CraigB-spinner/Arcade-Trackball/5050RGB_Pics/5050RGB circuit & pre-board.jpg

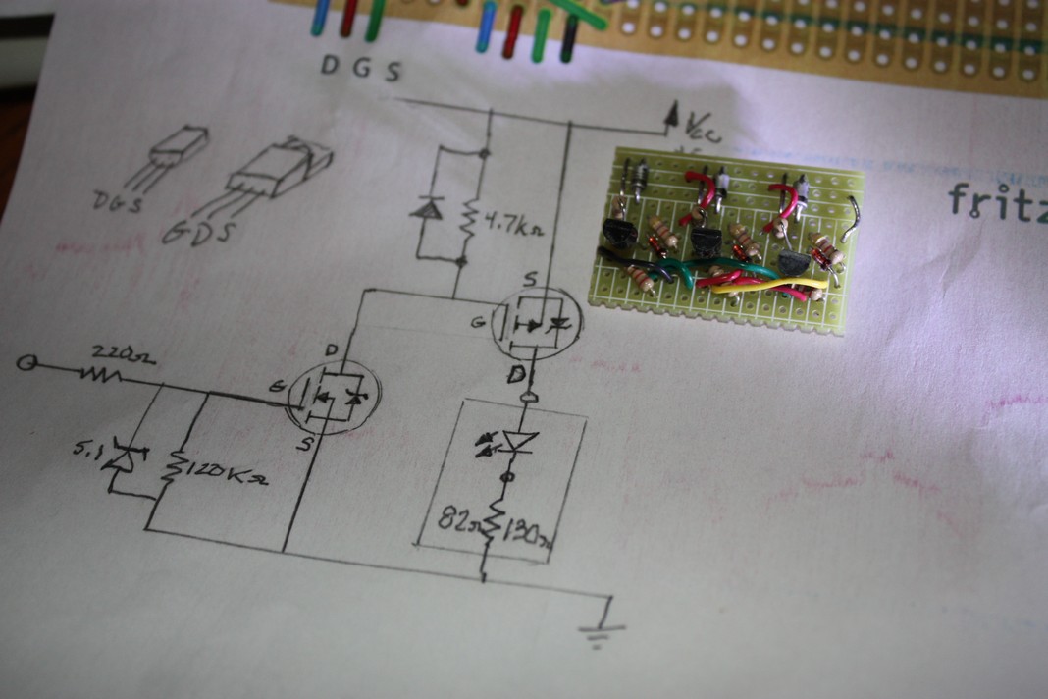
5050RGB_Pics/5050RGB circuit & pre-board.jpg
