CraigB-spinner/Arcade-Trackball/5050RGB_Pics/5050RGB strip wired.jpg

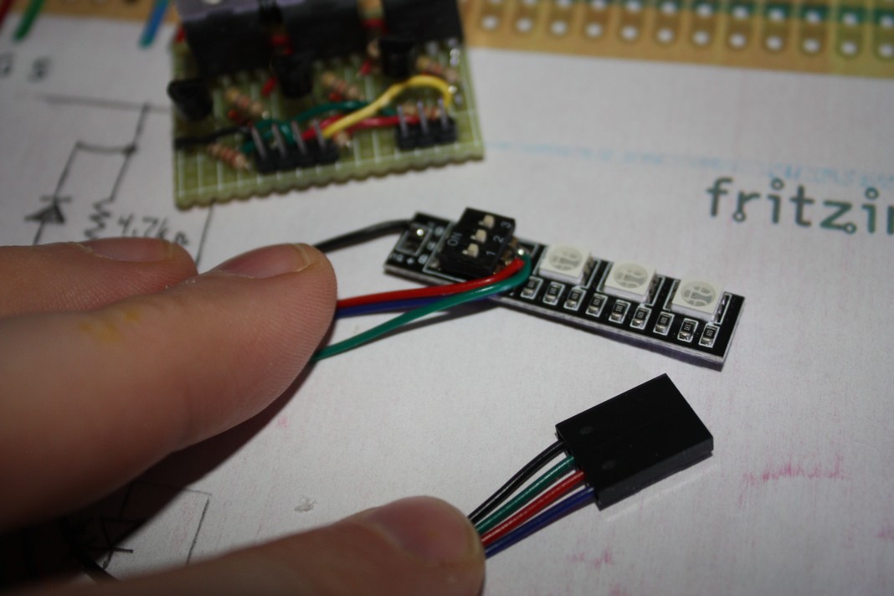
5050RGB_Pics/5050RGB strip wired.jpg
