CraigB-spinner/Arcade-Trackball/5050RGB_Pics/Finished 5050RGB driver.jpg

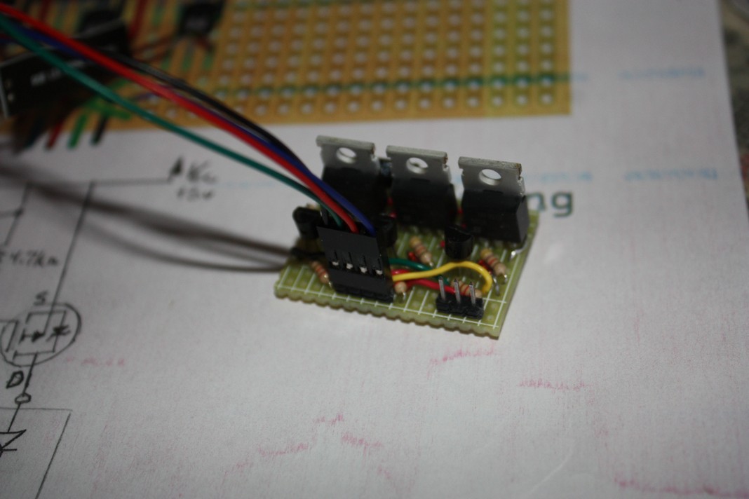
5050RGB_Pics/Finished 5050RGB driver.jpg
