CraigB-spinner/Arcade-Trackball/5050RGB_Pics/MOSFET-3-LED-Strip(red)-cc-3.jpg

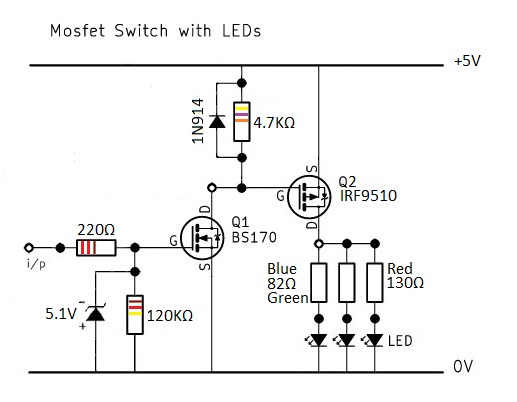
5050RGB_Pics/MOSFET-3-LED-Strip(red)-cc-3.jpg
