CraigB-spinner/Arcade-Trackball/5050RGB_Pics/RGB5050 circuit Sketch_bb.jpg

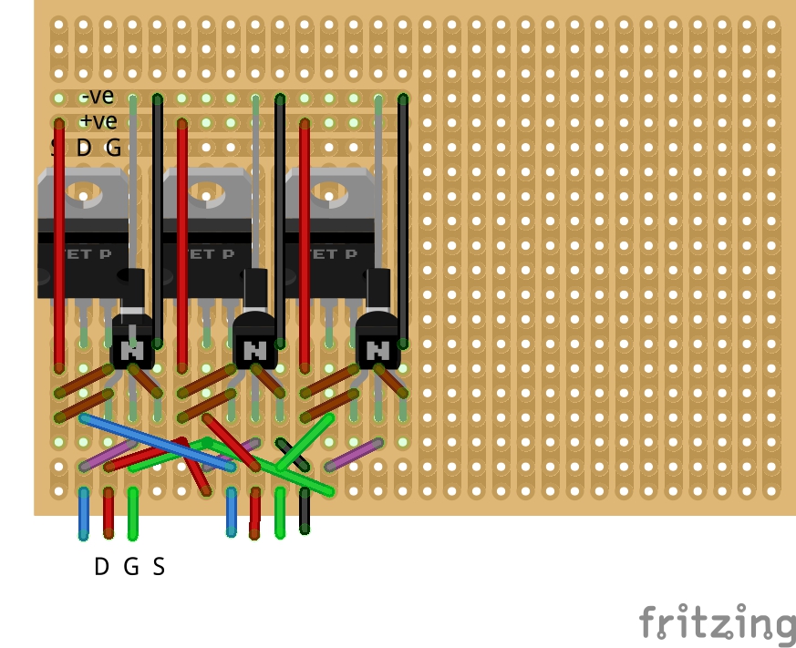
5050RGB_Pics/RGB5050 circuit Sketch_bb.jpg
