CraigB-spinner/Arcade-Trackball/Finished pictures/ATmega32U4 wired inside.jpg

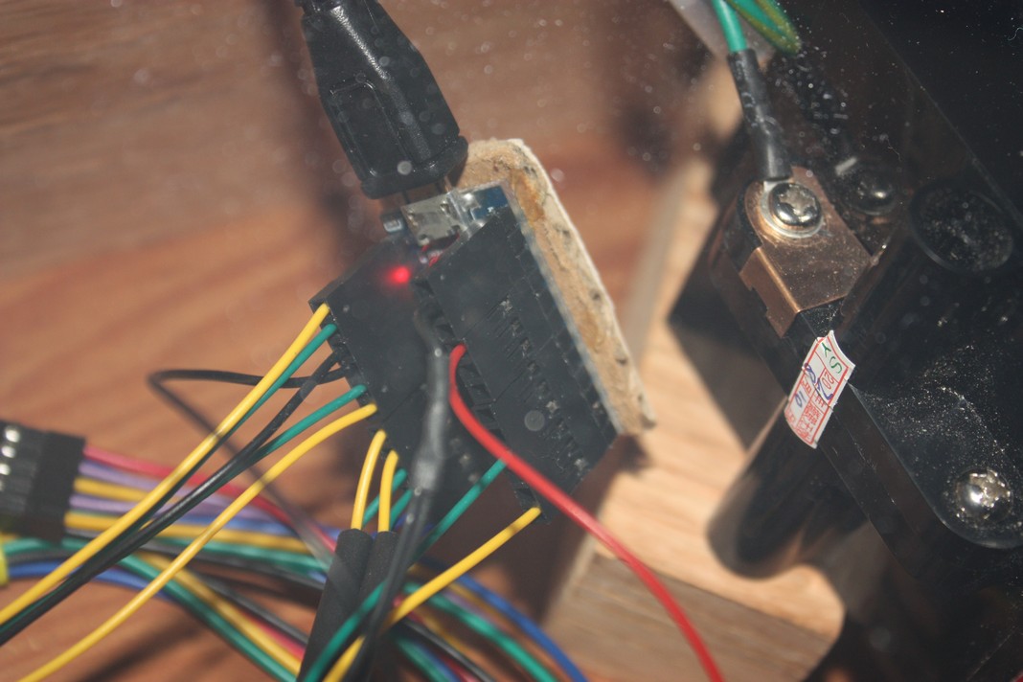
Finished pictures/ATmega32U4 wired inside.jpg
