CraigB-spinner/Arcade-Trackball/Finished pictures/Bottom-side.jpg

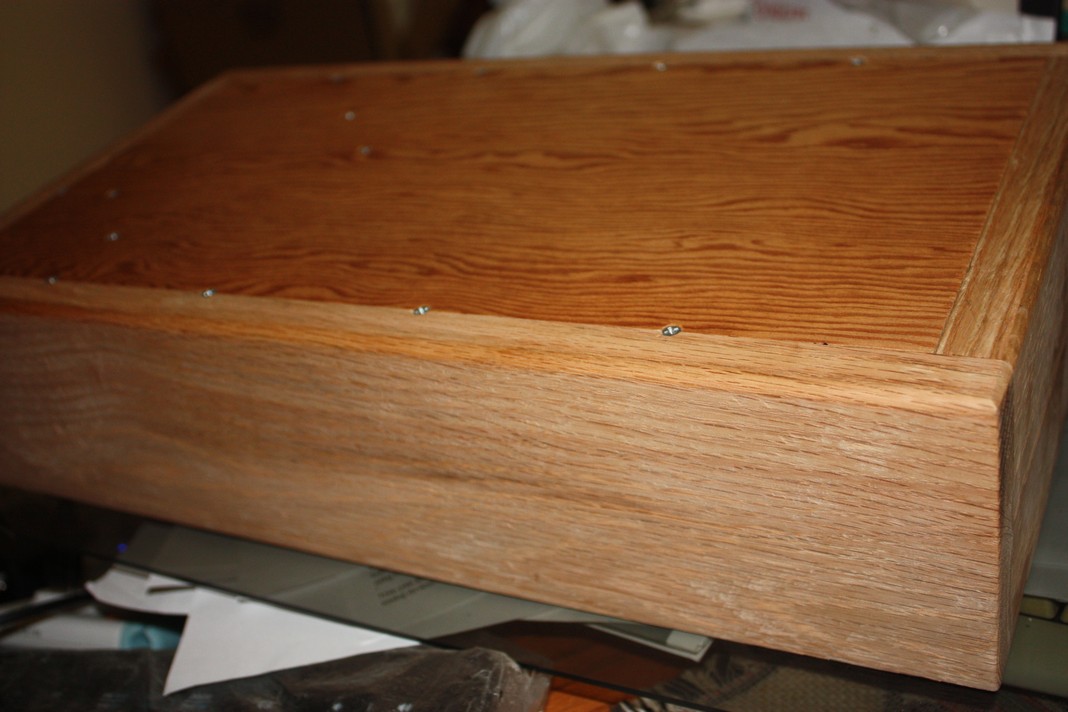
Finished pictures/Bottom-side.jpg
