CraigB-spinner/Arcade-Trackball/Finished pictures/Buttons.jpg

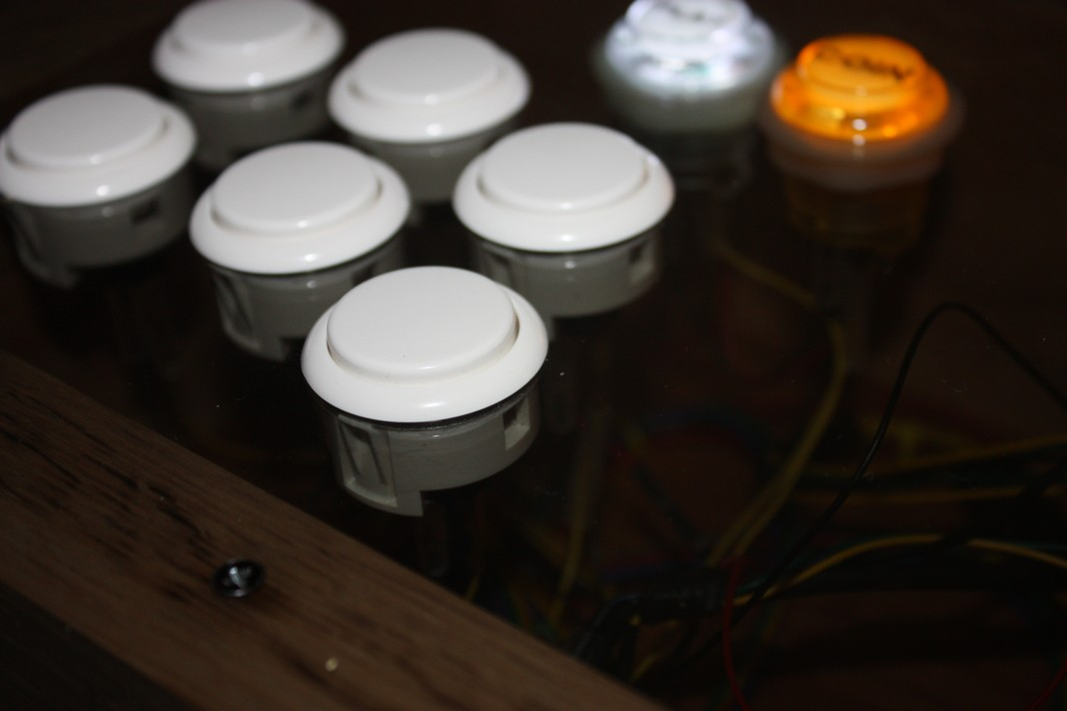
Finished pictures/Buttons.jpg
