CraigB-spinner/Arcade-Trackball/Finished pictures/See-thru-Top.jpg

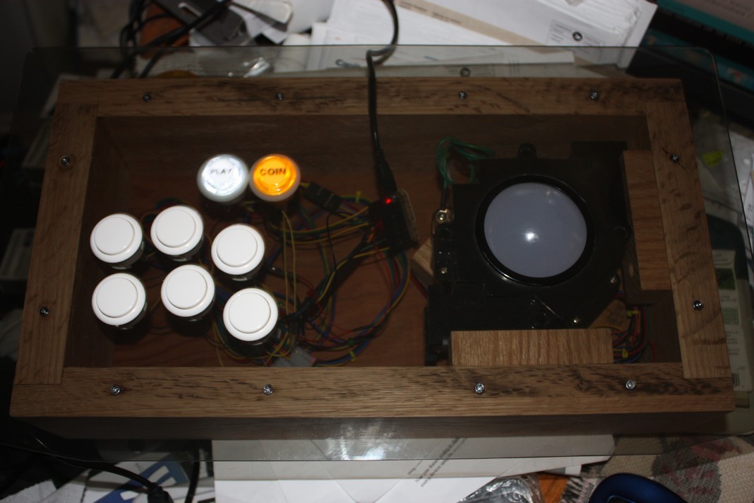
Finished pictures/See-thru-Top.jpg
