CraigB-spinner/Arcade-Trackball/Finished pictures/Trackball.jpg

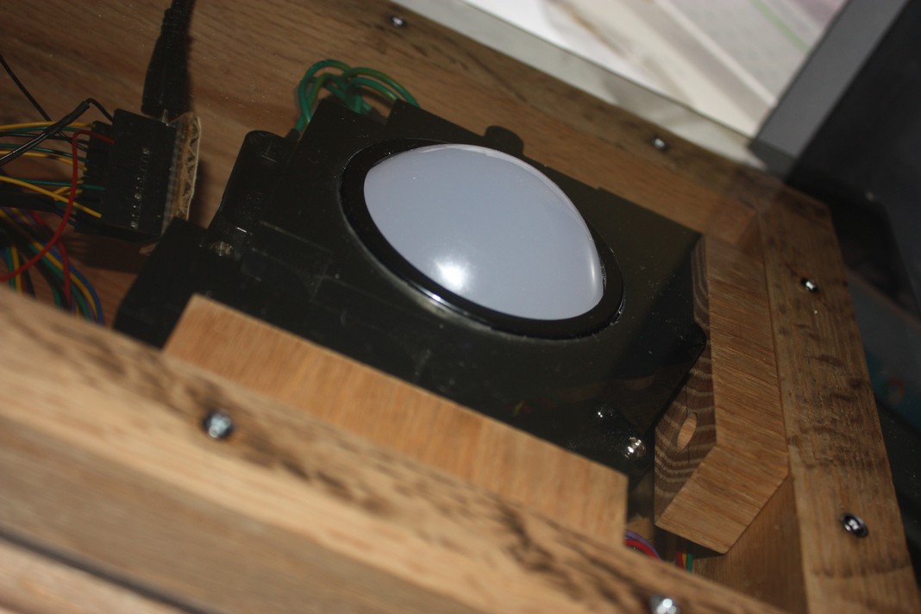
Finished pictures/Trackball.jpg
