CraigB-spinner/Arcade-Trackball/ICSP_Pics/ATMega32U4 - Fuse bits - Extended.jpg

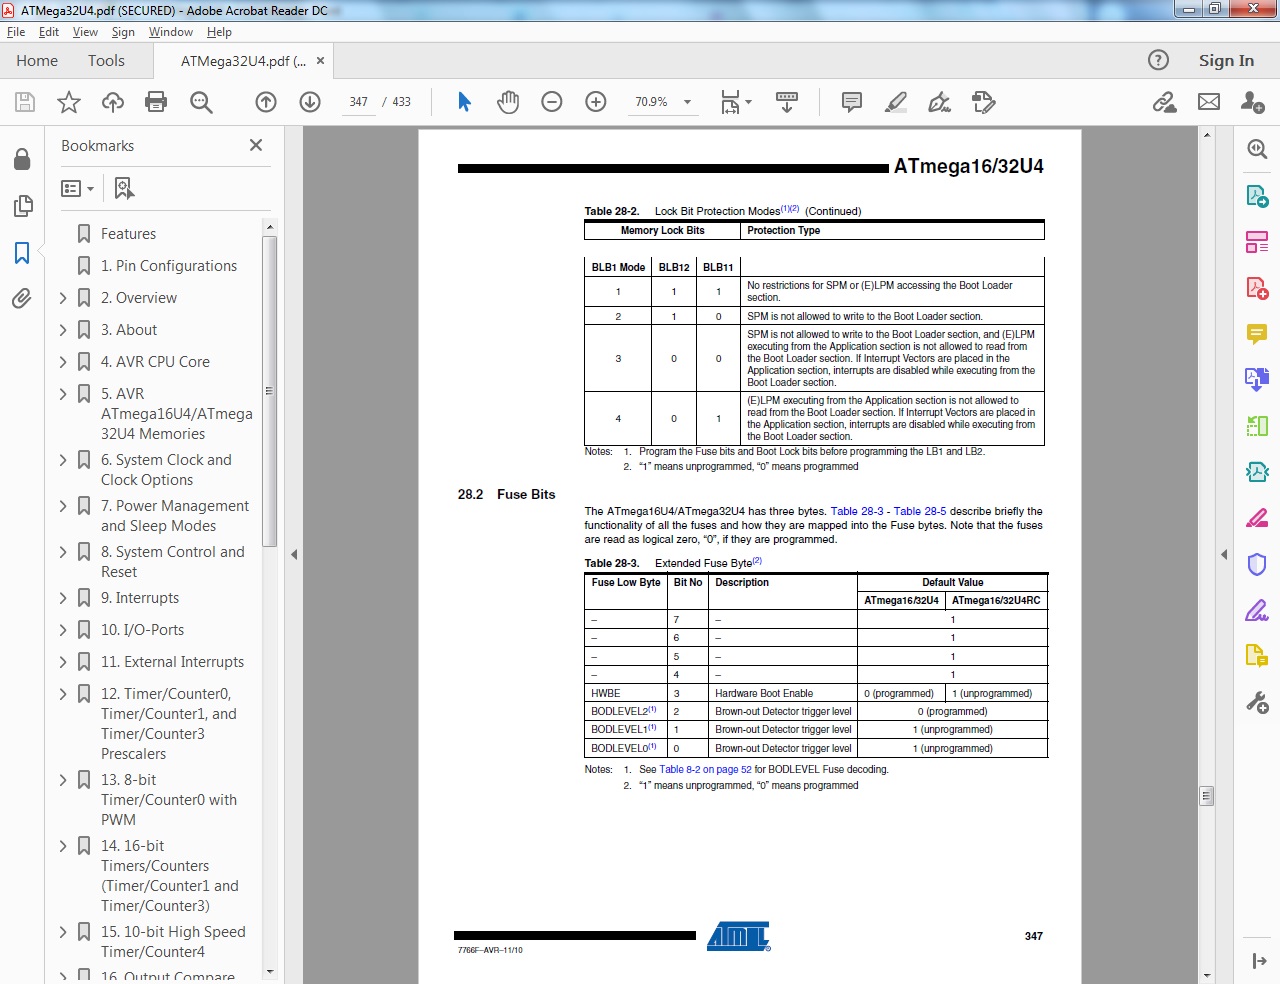
ICSP_Pics/ATMega32U4 - Fuse bits - Extended.jpg
