CraigB-spinner/Arcade-Trackball/ICSP_Pics/ATMega32U4 - Fuse bits - High & Low.jpg

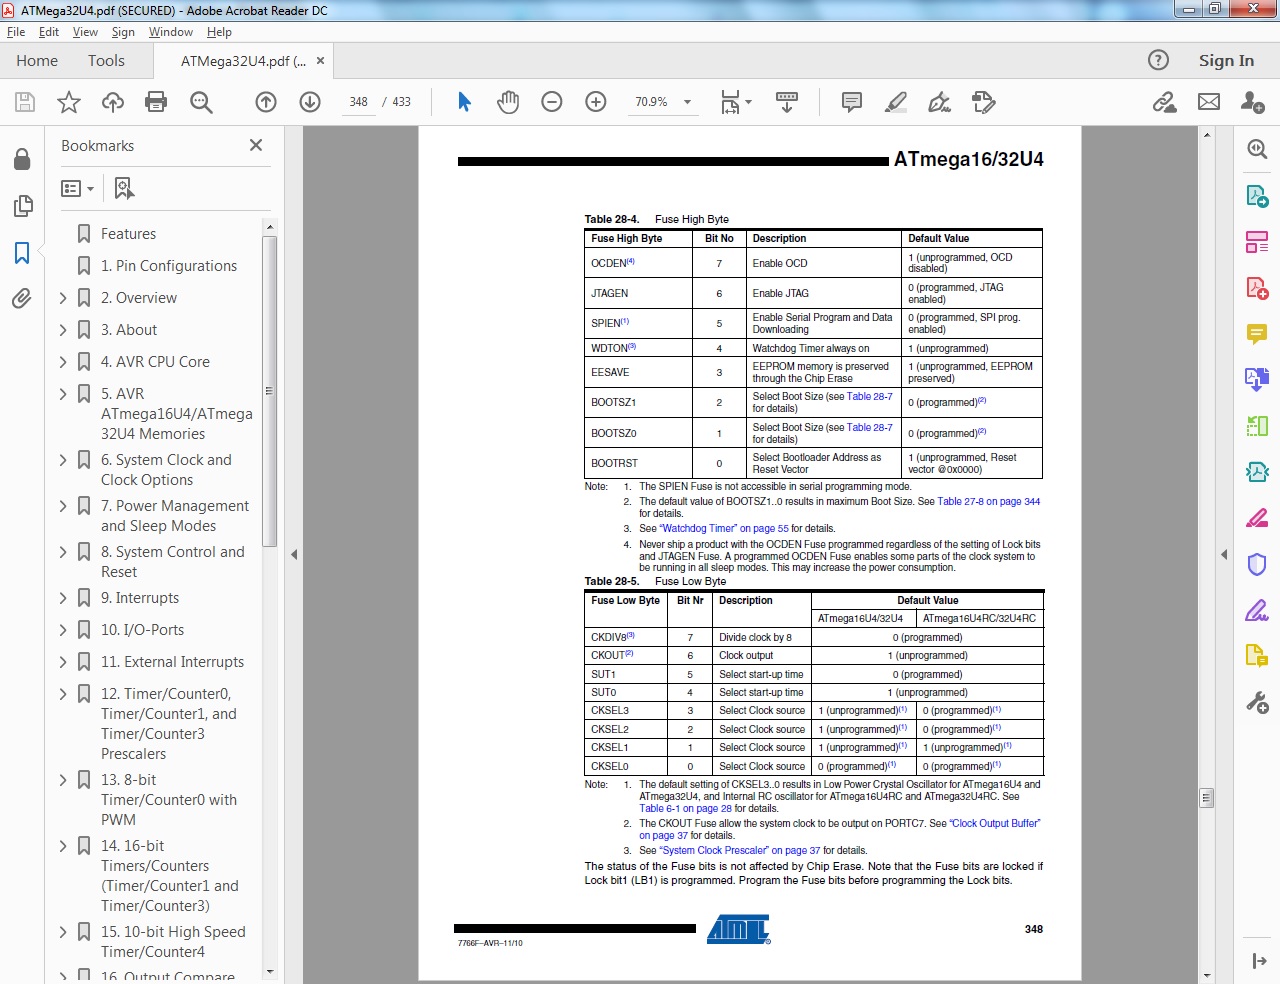
ICSP_Pics/ATMega32U4 - Fuse bits - High & Low.jpg
