CraigB-spinner/Arcade-Trackball/ICSP_Pics/ATMega32U4 - Lock bits.jpg

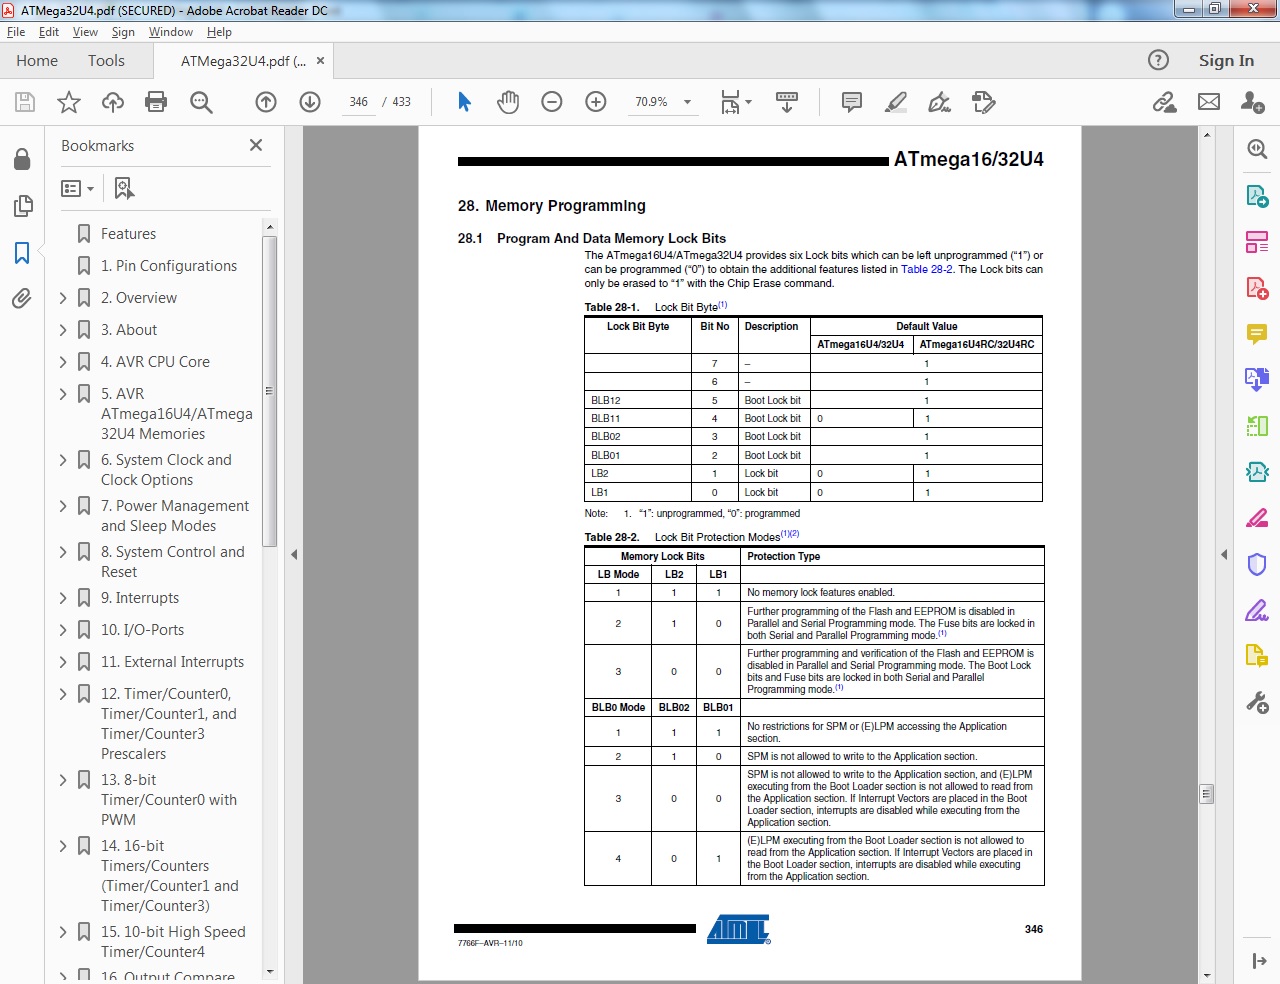
ICSP_Pics/ATMega32U4 - Lock bits.jpg
