CraigB-spinner/Arcade-Trackball/ICSP_Pics/AVRDUDESS bits.xml file update for Fuse & Lock Bits.jpg

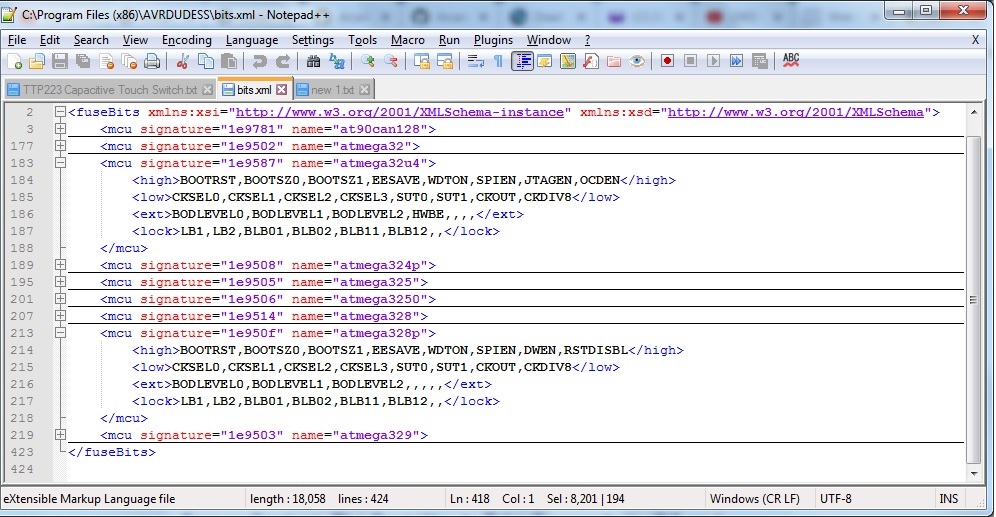
ICSP_Pics/AVRDUDESS bits.xml file update for Fuse & Lock Bits.jpg
