CraigB-spinner/Arcade-Trackball/ICSP_Pics/AVRDUDESS Fuse & Lock Bits.jpg

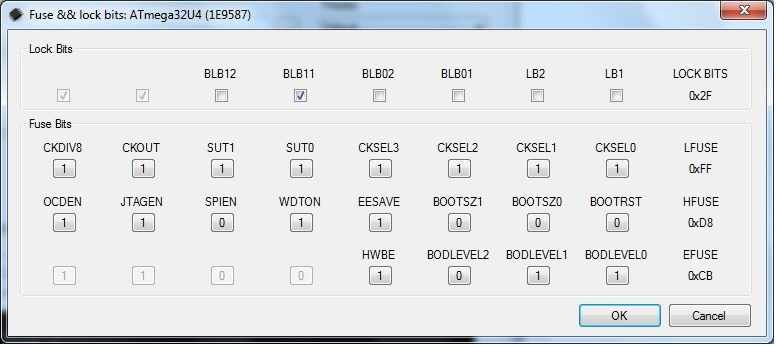
ICSP_Pics/AVRDUDESS Fuse & Lock Bits.jpg
