CraigB-spinner/Arcade-Trackball/ICSP_Pics/AVRDUDESS.jpg

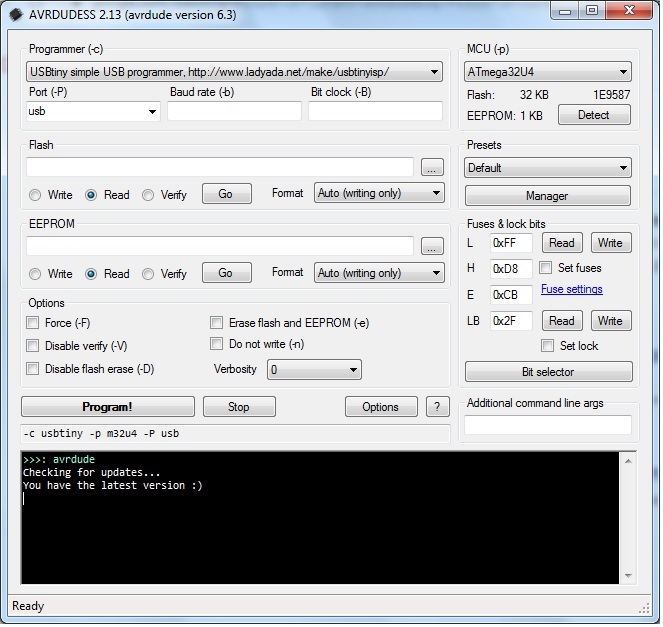
ICSP_Pics/AVRDUDESS.jpg
