CraigB-spinner/Arcade-Trackball/ICSP_Pics/USBtiny - Device Manager.jpg

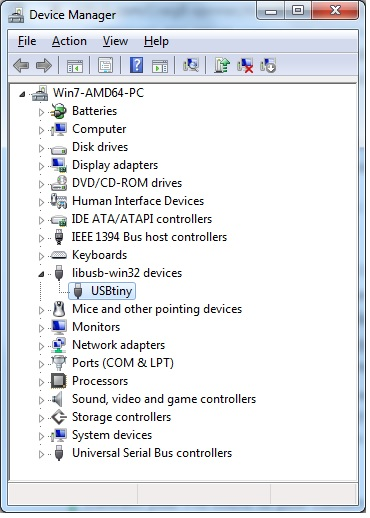
ICSP_Pics/USBtiny - Device Manager.jpg
