CraigB-spinner/Arcade-Trackball/Pics/MOSFET-3-LED-Strip(red)-ca.jpg

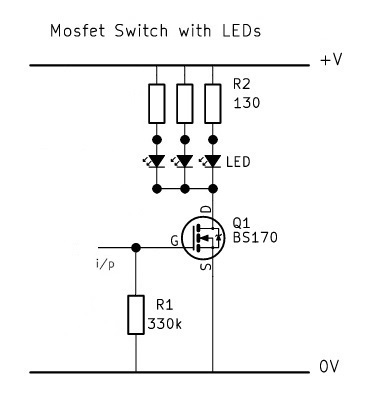
Pics/MOSFET-3-LED-Strip(red)-ca.jpg
