CraigB-spinner/Arcade-Trackball/Pics/MOSFET-3-LED-Strip(red)-cc.jpg

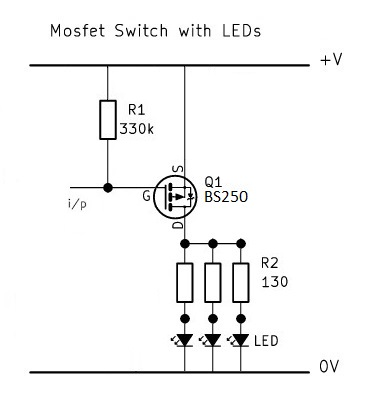
Pics/MOSFET-3-LED-Strip(red)-cc.jpg
