CraigB-spinner/Arcade-Trackball/Pics/RA-TRACK-BALL-No-Harness.jpg

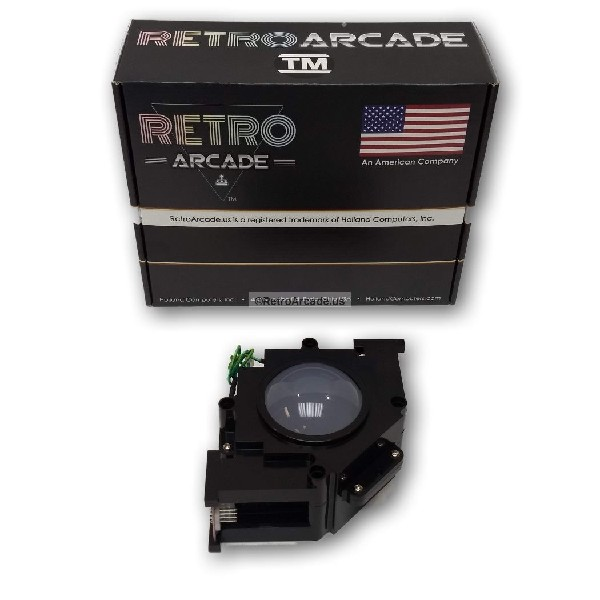
Pics/RA-TRACK-BALL-No-Harness.jpg
