CraigB-spinner/Arcade-Trackball/Pics/RA-TRACKBALL-1-Jamma-60-in-1.jpg

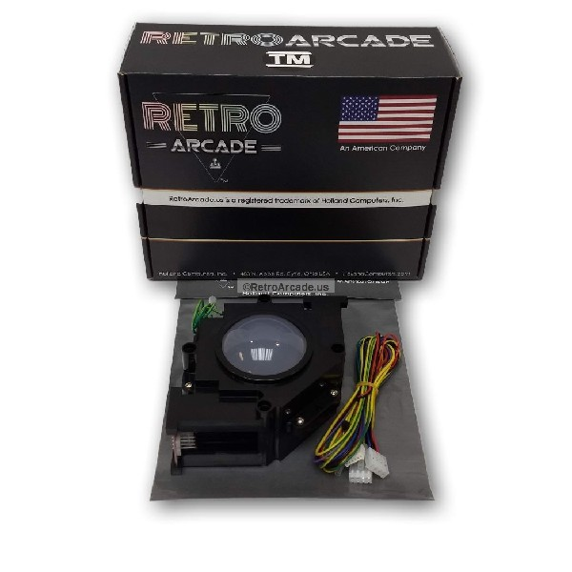
Pics/RA-TRACKBALL-1-Jamma-60-in-1.jpg
