CraigB-spinner/Arcade-Trackball/Pics/RA-Trackball-2 dimensions.jpg

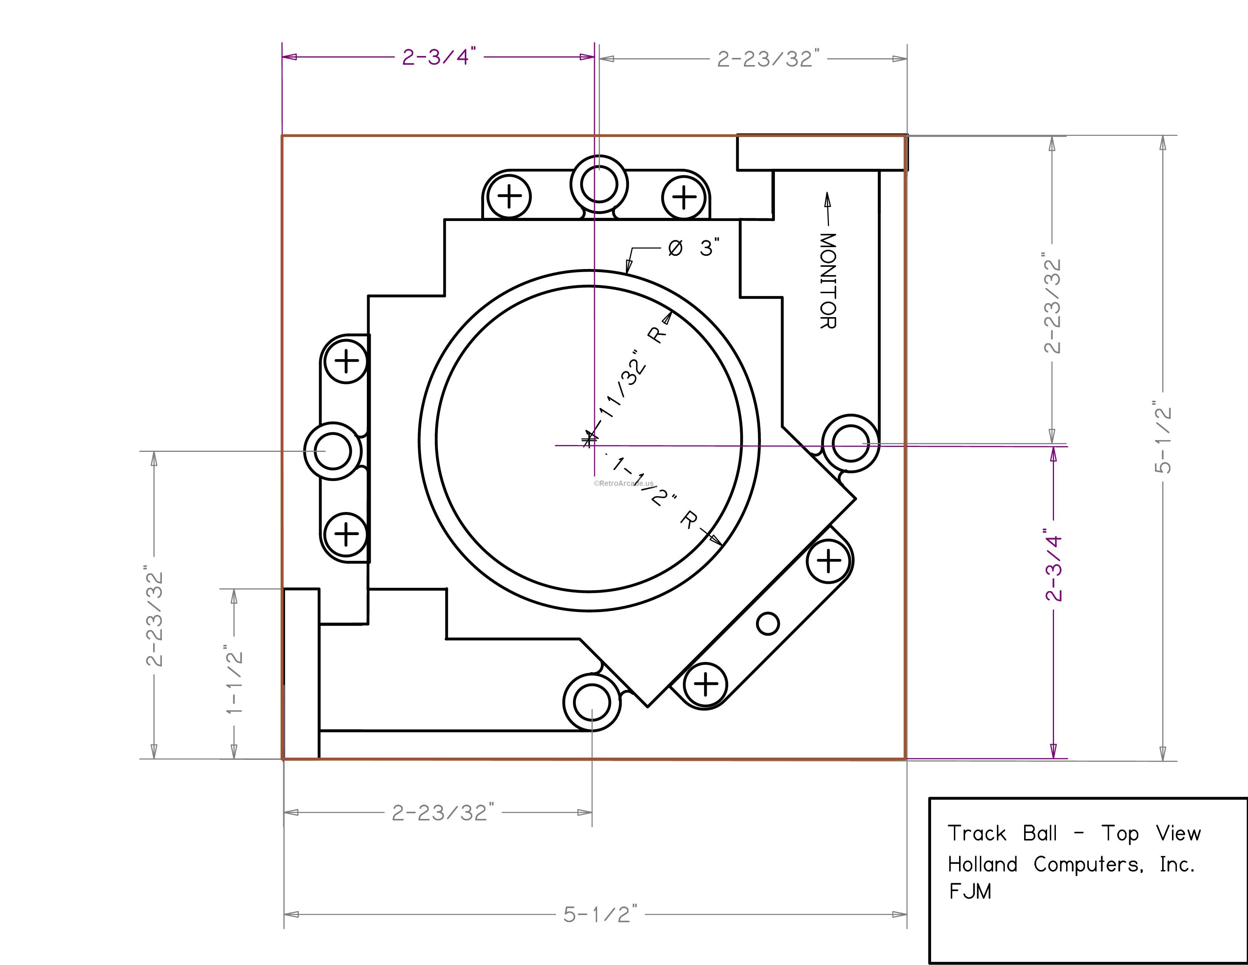
Pics/RA-Trackball-2 dimensions.jpg
