CraigB-spinner/Arcade-Trackball/Pics/RA-TRACKBALL-2-GameElf-412-in-1.jpg

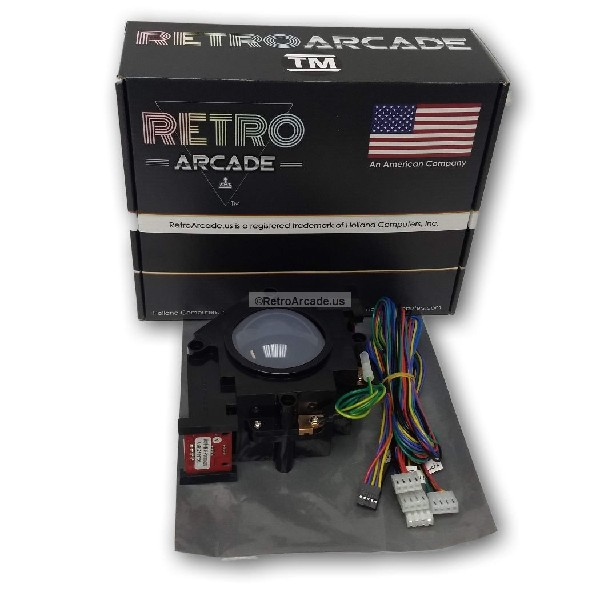
Pics/RA-TRACKBALL-2-GameElf-412-in-1.jpg
