CraigB-spinner/Arcade-Trackball/Pics/Red_Board_Pinout.jpg

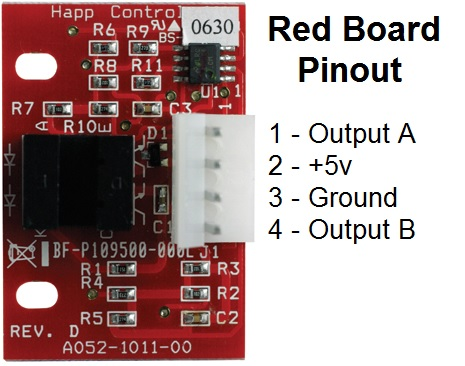
Pics/Red_Board_Pinout.jpg
