CraigB-spinner/Arcade-Trackball/Pics/Retro Arcade 3in Trackball and Harness.jpg

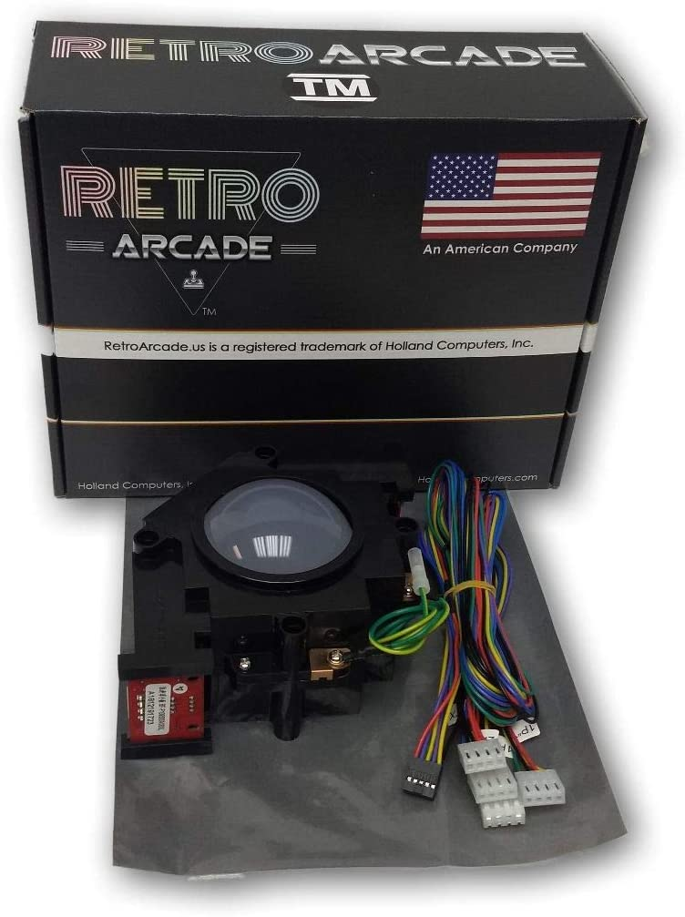
Pics/Retro Arcade 3in Trackball and Harness.jpg
