CraigB-spinner/Arcade-Trackball/Pics/RGB5050_board.jpg

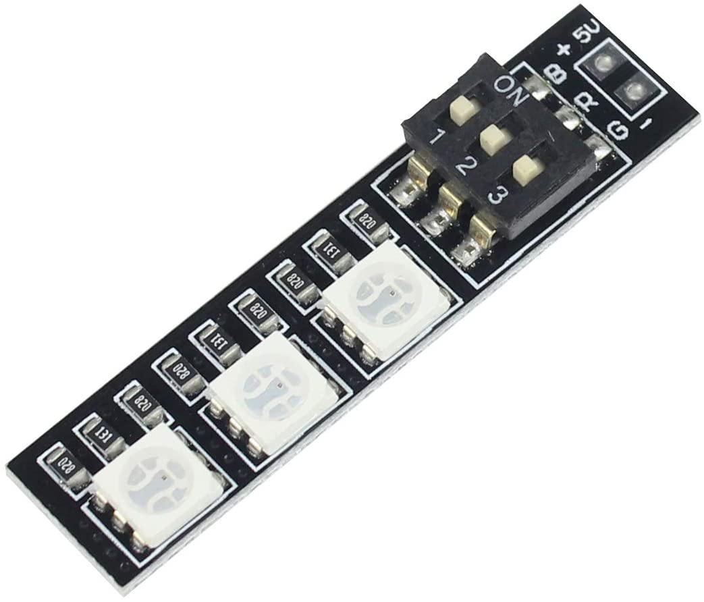
Pics/RGB5050_board.jpg
