CraigB-spinner/Arcade-Trackball/Pics/Special Touch Buttons.jpg

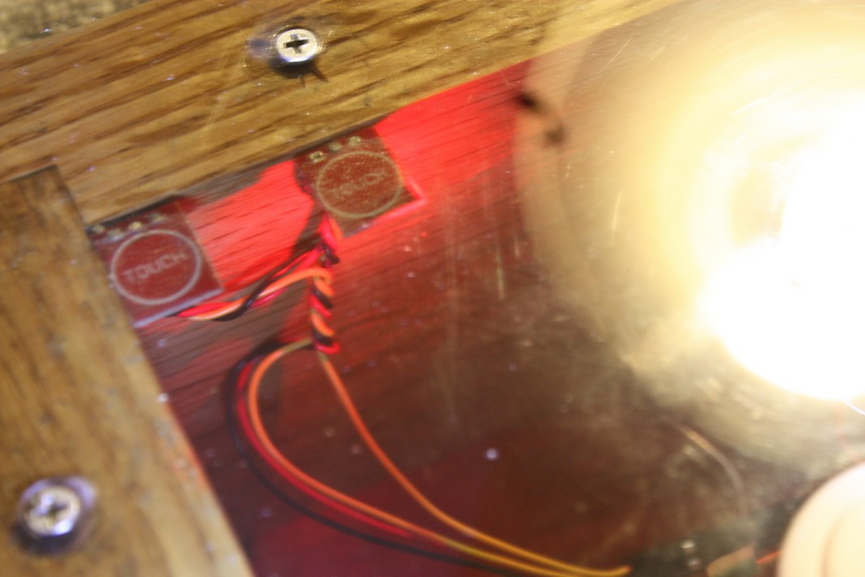
Pics/Special Touch Buttons.jpg
