CraigB-spinner/Arcade-Trackball/Pics/Trackball 2x5 pin connector.jpg

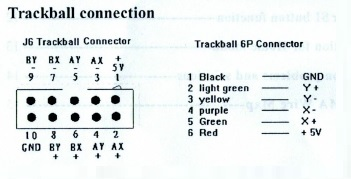
Pics/Trackball 2x5 pin connector.jpg
