CraigB-spinner/Arcade-Trackball/Pics/Trackball Sketch_bb.jpg

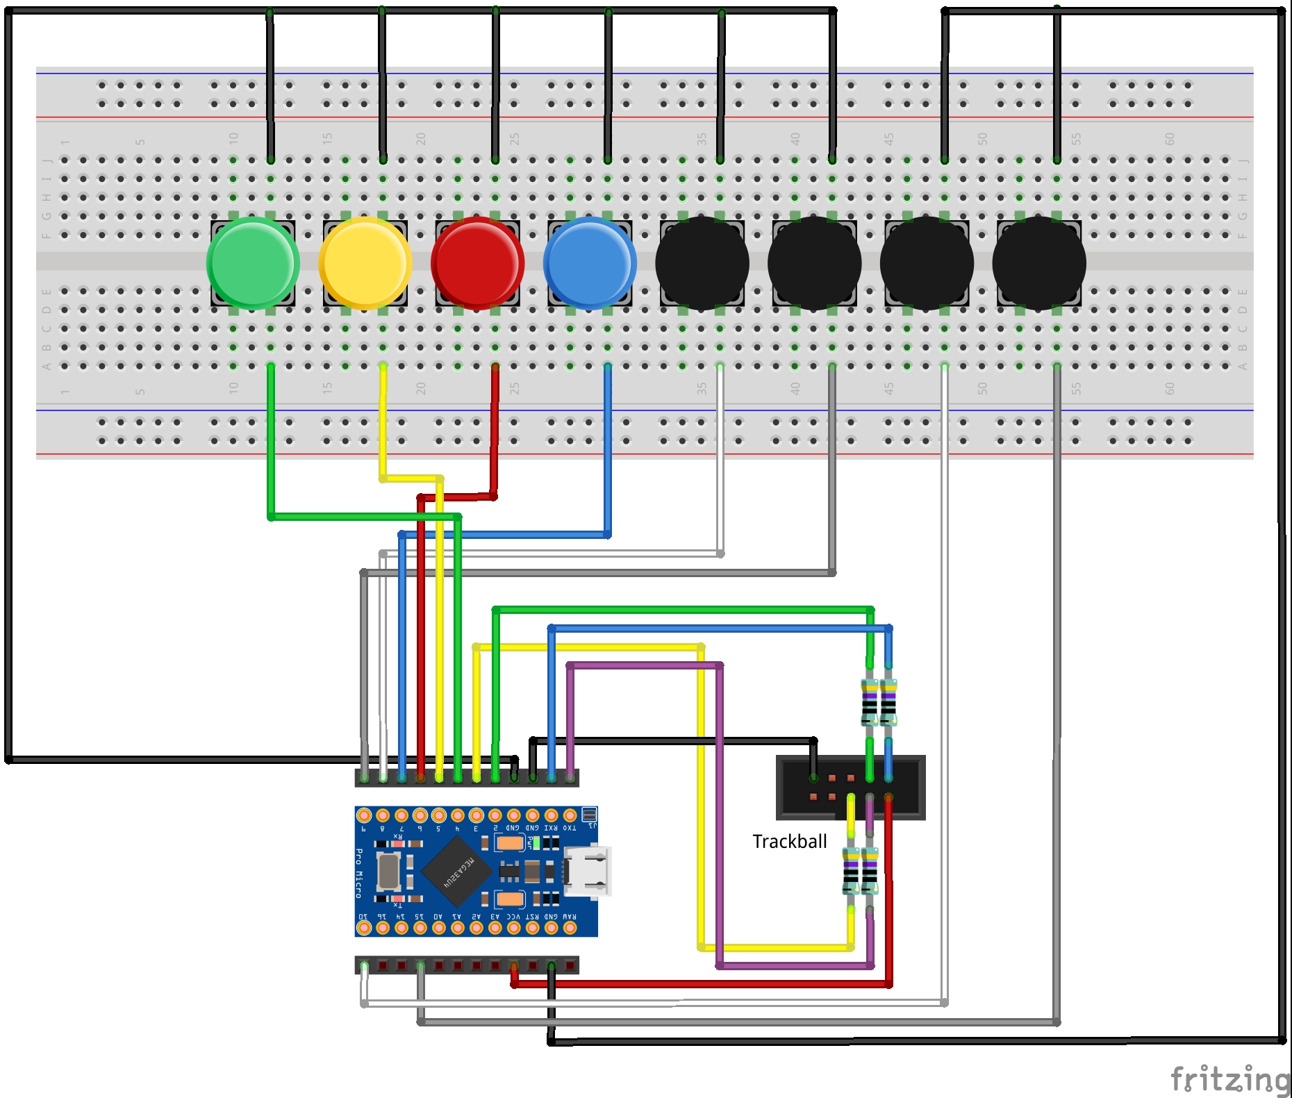
Pics/Trackball Sketch_bb.jpg
