CraigB-spinner/Arcade-Trackball/Pics/TrackBox Layout dimensions.png

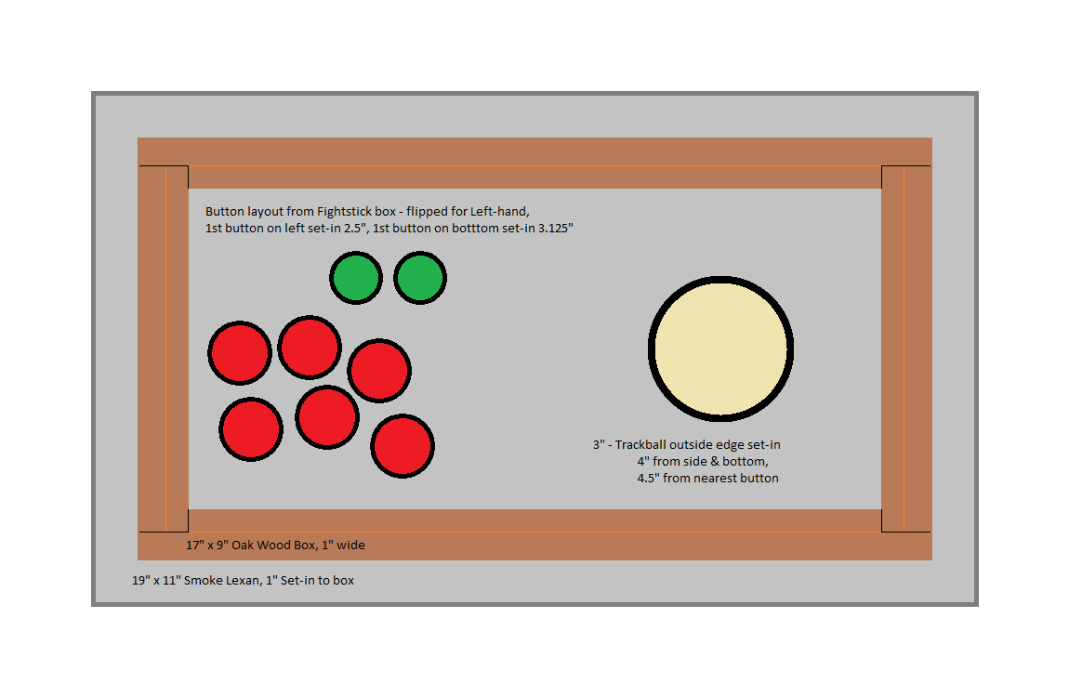
Pics/TrackBox Layout dimensions.png
