CraigB-spinner/Arcade-Trackball/Pics/USBtinyISP-Programmer+DIY-Harness.jpg

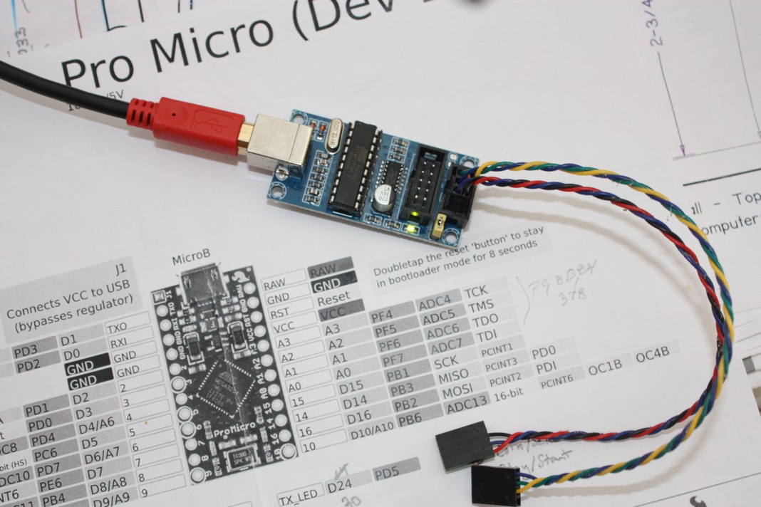
Pics/USBtinyISP-Programmer+DIY-Harness.jpg
