CraigB-spinner/Arcade-Trackball/Trackball_6-Button-MiSTer.ino

/*   Arcade Trackball/Spinner v2.02
*    (new trackball/mouse dual x and y axis - added pinC & pinD - RX1/PD2, TX0/PD3 data pins)
*    Mouse and Joystick (Arcade Trackball) version with Joystick override using buttons for menu navigation.
*
*    Craig B  - (craigbspinner@gmail.com)
*    Copyright 2020 Craig B - based on Spinner code from early June 2019 
*                   Craig B - Updated 70% of code, 
*                             Added spinner movement ACCM/DROP, 
*                             Optimized code speed by changing if logic to case statement logic for Button validation of port bits.
*                   Craig B - Added code for spinner movement NORM/ACCS/ACCX - End of June 2019         
*                   Craig B - Added code for mouse y-axis and interupt processing from late Aug 2020
*                   Craig B - Added ACCSX code for mouse larger movement for both axes late Nov 2020 (issue with mouse sensitivity in MAME)
*                   Craig B - Added code for x-axis disable (golf drive - no hook/slice cheat) from mid Dec 2020   
*                   Craig B - Added code for joystick override using buttons from mid Dec 2020   
*                   Craig B - New code for trackball Vari-Spin movement ACCS from end Dec 2022   
*    
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
*    You should have received a copy of the GNU General Public License
*    along with this program.  If not, see <https://www.gnu.org/licenses/>.
*/

#include "Mouse.h"
#include <Joystick.h>

/*   RetroPie mods - Arduino IDE -> Tools, Get Board Info
*    VID: 1B4F
*    PID: 9206
*    Add the following to /boot/cmdline.txt -- just add a space to the end of the existing entry, so it is all on one line):
*    usbhid.quirks=0x16c0:0x05e1:0x040
*    The first two numbers are the vendor ID 16c0 and product ID 05e1.
*/

// Port Bit/Pin layout   
//      Bit - 76543210 - Silk screen ## - Micro-Controller
#define xPD3 0b00001000 //Digital Pin 0  - Micro/PRO Micro - TX,  INT3
#define xPD2 0b00000100 //Digital Pin 1  - Micro/PRO Micro - RX,  INT2
#define xPD1 0b00000010 //Digital Pin 2  - Micro/PRO Micro - SDA, INT0
#define xPD0 0b00000001 //Digital Pin 3  - Micro/PRO Micro - SCL, INT1
#define xPD_10 (xPD1 | xPD0)
#define xPD_32 (xPD3 | xPD2)
#define xPD4 0b00010000 //Digital Pin 4  - Micro/PRO Micro
#define xPC6 0b01000000 //Digital Pin 5  - Micro/PRO Micro
#define xPD7 0b10000000 //Digital Pin 6  - Micro/PRO Micro
#define xPE6 0b01000000 //Digital Pin 7  - Micro/PRO Micro
#define xPB4 0b00010000 //Digital Pin 8  - Micro/PRO Micro
#define xPB5 0b00100000 //Digital Pin 9  - Micro/PRO Micro
#define xPB6 0b01000000 //Digital Pin 10 - Micro/PRO Micro
#define xPB7 0b10000000 //Digital Pin 11 - Micro
#define xPD6 0b01000000 //Digital Pin 12 - Micro
#define xPC7 0b10000000 //Digital Pin 13 - Micro
#define xPB3 0b00001000 //Digital Pin 14 - PRO Micro
#define xPB1 0b00000010 //Digital Pin 15 - PRO Micro
#define xPB2 0b00000100 //Digital Pin 16 - PRO Micro

//   Arcade Trackball/Mouse requires ACCS movement.
//   axis wheel is 24T with 3" ball, 0.425" roller -> 24 x (3000/425) = 169.412  holes/revs
//   4 edge transistions Hi/Low and Low/Hi x 2 sensors per axis = 169.412 x 4 = 677.647 pulses/revs 
//   Double sensor required to indicate rotation direction in single axis 
//
//   Arcade Spinner/Mouse requires ACCM movement.
//   2400 pulses/revs divide by two
    
//Mouse movement - pick one to compile specific code inside loop()
#define ACCS   //Mouse movement Accelerated; every interrupt processed but accelerated movement, no lag x1, 1 pulse = 1 move 
#define ACCSX 1   //Mouse movement Accelerated; every interrupt processed but 2x accelerated movement, no lag x1, 1 pulse = 2 move (use with ACCS)
//#define ACCSX 2   //Mouse movement Accelerated; every interrupt processed but 4x accelerated movement, no lag x1, 1 pulse = 4 move (use with ACCS)
//#define ACCM   //Mouse movement Accelerated; every interrupt processed but accelerated movement, no lag x2, 2 pulse = 1 move
//#define ACCX   //Mouse movement Accelerated; every interrupt processed but accelerated movement, no lag x4, 4 pulse = 1 move

#define pinA 2    //The pins that the trackball/mouse x-axis encoder's A and B terminals are connected to.
#define pinB 3
#define pinC 0    //The pins that the trackball/mouse y-axis encoder's C and D terminals are connected to.
#define pinD 1

#define maxBut 10       //Update lastButtonState array below when changing number of elements.
#define axisEnable 6  //Special x-axis disable button (button offset: 0 thru 9) - comment out if 'x-axis disable' feature not required by you.
//#define joyStmp    7  //button for temp JoyStick override (button offset: 0 thru 9) - comment out if 'JoyStick override' feature not required by you.

#ifdef joyStmp
int joyStOn = 1;      //Joystick override status of button - off
#endif
#define butPrs 0      //Button pulled low when pressed
#define butOff 1      //Button pullup high when not pressed

//Create a Joystick object.
Joystick_ Joystick(JOYSTICK_DEFAULT_REPORT_ID,JOYSTICK_TYPE_GAMEPAD,
  maxBut, 0,             // Button Count, Hat Switch Count
  true, true, false,     // X, but no Y or Z Axis. We need at least one axis even though it's not really used.
  false, false, false,   // No Rx, Ry, or Rz
  false, false,          // No rudder or throttle
  false, false, false);  // No accelerator, brake, or steering;

//The previous state of the AB pins
volatile int prevQuadratureX = 0;
//The previous state of the CD pins
volatile int prevQuadratureY = 0;

//Keeps track of how much the encoder has been moved
volatile int rotPositionX = 0;
volatile int rotMultiX = 0;
#ifdef axisEnable
volatile int xAxis = 1; 
#endif
volatile int rotPositionY = 0;
volatile int rotMultiY = 0;

int rotCtrLmt = 1;
unsigned long adjTime = 0;
int butLock = 0;
#define delayTime 250
#define upBut  4
#define dwnBut 5

// Last state of 10 buttons (update array for your maxBut buttons)
// Since Button Port Bits are set to 1 to activate(pull-hi input resistors), the press state is low, and not pressed is high.
// axisEnable 6, joyStmp 7 (button offset: 0 thru 9)
#ifdef axisEnable
#ifdef joyStmp
int lastButtonState[maxBut] = {1,1,1,1,1,1,1,1,1,1};
#else
int lastButtonState[maxBut] = {1,1,1,1,1,1,1,0,1,1};
#endif
#elif joyStmp
int lastButtonState[maxBut] = {1,1,1,1,1,1,0,1,1,1};
#else
int lastButtonState[maxBut] = {1,1,1,1,1,1,0,0,1,1};
#endif


//---------------------------------------------------------------------
void setup() {
  //No need to set the pin modes with DDRx = DDRx | 0b00000000 as we're using all input and that's the initial state of the pins
  
  //Use internal input resistors for all the pins we're using - pull high resistor, when button pressed (short to ground) input on pin is pulled low.
  //Digital pin D# corresponds to silk screen on micro-controller board, (#) corresponds to port bit internal use MSD(7)-to-LSD(0) - you assign button # in code
//PORTD = 0b10010011; //Digital pins D2(1), D3(0), D4(4), and D6(7). - Spinner x-axis only, and (Button 1 & 3)
  PORTD = 0b10011111; //Digital pins D2(1), D3(0), D0(2), D1(3), D4(4), and D6(7). - Trackball x/y-axis, and (Button 1 & 3)
//PORTB = 0b01110010; //Digital pins D8(4), D9(5), D10(6), and D15(1). D14(3), D16(2) requires PB0 set high(master). - (Button 5, 6, 9 & 10)
#ifdef axisEnable     // D16 - PB2 & PB0 hi
#ifdef joyStmp        // D14 - PB3 hi
  PORTB = 0b01111111; //(Button 5, 6, 7-Axis, 8-Joys, 9 & 10)
#else
  PORTB = 0b01110010; //(Button 5, 6, 7-Axis, 9 & 10)
#endif
#elif joyStmp
  PORTB = 0b01111010; //(Button 5, 6, 8-Joys, 9 & 10)
#else
  PORTB = 0b01110111; //(Button 5, 6, 9 & 10)
#endif  
  PORTC = 0b01000000; //Digital pin D5(6). - (Button 2)
  PORTE = 0b01000000; //Digital pin D7(6). - (Button 4)
//PORTF = 0b11000000; //Digital pins A0(7) & A1(6). A2(5), A3(4) 

  //Start the joystick
  Joystick.begin();
  
  //Center the X axis on the joystick
  Joystick.setXAxis(511);
  Joystick.setYAxis(511);

  //Set up the interrupt handler for the encoder's A and B terminals on digital pins 2 and 3 respectively. Both interrupts use the same handler.
  attachInterrupt(digitalPinToInterrupt(pinA), pinChangeX, CHANGE); 
  attachInterrupt(digitalPinToInterrupt(pinB), pinChangeX, CHANGE);
  //Set up the interrupt handler for the encoder's C and D terminals on digital pins 0 and 1 respectively. Both interrupts use the same handler.
  attachInterrupt(digitalPinToInterrupt(pinC), pinChangeY, CHANGE); 
  attachInterrupt(digitalPinToInterrupt(pinD), pinChangeY, CHANGE);

  //Start the mouse
  Mouse.begin();
}

//may want to add mouse left, mid, right button press functionality instead joystick buttons at code bottom
//char button MOUSE_LEFT(default), MOUSE_RIGHT, MOUSE_MIDDLE
//Mouse.press(button)   
//Mouse.release(button) 
//Mouse.click(button)  
//Mouse.isPressed(button)  returns bool 

//---------------------------------------------------------------------
//Interrupt handler x-axis
void pinChangeX() {

  //Set currQuadratureX to state of rotary encoder terminals A & B from input of PORTD bits 0 & 1 (digital pins 2 and 3)
  //You could do int currQuadratureX = (digitalRead(pinA) << 1) | digitalRead(pinB); to get the same thing, but it would be much slower.
  //Read current state 00AB.
  int currQuadratureX = PIND & xPD_10;

  //Store comboQuadratureX with previous and current quadrature rotary encoder states together. 
  //Combined previous/current states form two groups of four unique bit patterns indicating direction of movement.
  //Shift left 2 bits: 00AB <- AB00 to store current state as previous state.
  int comboQuadratureX  = (prevQuadratureX << 2) | currQuadratureX; 

  //Rotate to the right, Clockwise
  //State 00AB, A leads B. A0 -> AB -> 0B -> 00 0b0010 0b1011 0b1101 0b0100
  if(comboQuadratureX == 0b0010 || comboQuadratureX == 0b1011 ||
     comboQuadratureX == 0b1101 || comboQuadratureX == 0b0100) {
  #ifdef axisEnable
     rotPositionX += (xAxis);          //update the position of the encoder
  #else
     rotPositionX++;                   //update the position of the encoder
  #endif
  }

  //Rotate to the left, Counter Clockwise
  //State 00AB, B leads A. 0B -> AB -> A0 -> 00 0b0001 0b0111 0b1110 0b1000
  if(comboQuadratureX == 0b0001 || comboQuadratureX == 0b0111 ||
     comboQuadratureX == 0b1110 || comboQuadratureX == 0b1000) {
  #ifdef axisEnable
     rotPositionX -= (xAxis);          //update the position of the encoder
  #else
     rotPositionX--;                   //update the position of the encoder
  #endif
  }

  //Save the previous state of the A and B terminals for next time
  prevQuadratureX = currQuadratureX;
}


//---------------------------------------------------------------------
//Interrupt handler y-axis
void pinChangeY() {

  //Set currQuadratureY to state of rotary encoder terminals A & B from input of PORTD bits 2 & 3 (digital pins 0 and 1) 
  //You could do int currQuadratureY = (digitalRead(pinC) << 1) | digitalRead(pinD); to get the same thing, but it would be much slower.
  //Read current state CD00.
  int currQuadratureY = PIND & xPD_32;

  //Store comboQuadratureY with current and previous quadrature rotary encoder states together. 
  //Combined current/previous states form two groups of four unique bit patterns indicating direction of movement.
  //Shift right 2 bits: CD00 -> 00CD to store current state as previous state.
  int comboQuadratureY  = (prevQuadratureY >> 2) | currQuadratureY; 

  //Rotate to the right, Clockwise
  //State CD00, C leads D. C0 -> CD -> 0D -> 00 0b1000 0b1110 0b0111 0b0001
  if(comboQuadratureY == 0b1000 || comboQuadratureY == 0b1110 || 
     comboQuadratureY == 0b0111 || comboQuadratureY == 0b0001) { 
     rotPositionY++;                   //update the position of the encoder
  }

  //Rotate to the left, Counter Clockwise
  //State CD00, D leads C. 0D -> CD -> C0 -> 00 0b0100 0b1101 0b1011 0b0010
  if(comboQuadratureY == 0b0100 || comboQuadratureY == 0b1101 ||
     comboQuadratureY == 0b1011 || comboQuadratureY == 0b0010) {
     rotPositionY--;                   //update the position of the encoder
  }

  //Save the previous state of the C and D terminals for next time
  prevQuadratureY = currQuadratureY;
}


//---------------------------------------------------------------------
//Process the x/y axis mouse movement using one criteria (NORM, DROP, ACCS, ACCM, ACCX)
//most criteria process two edge transistions before moving the mouse/spinner pointer.
//Then cycle thru eight button states 1, 2, 3, 4, 5, 6, Coin(9), Start(10), to trigger button press/release on joystick
void loop(){ 
  int currentButtonState;
  int rotCtr;

// *** Spinner movement logic ***

#ifdef ACCS
  //If the encoder has moved 1-50 or more transitions move the mouse in the appropriate direction 
  //and update the position variable to reflect that we moved the mouse. Accelerated move.
//  Process X-axis
  rotMultiX = 0;
  if (rotPositionX >= rotCtrLmt || rotPositionX <= -rotCtrLmt) {
    rotCtr = 0;
    while (rotPositionX >= rotCtrLmt) {
      rotPositionX -= rotCtrLmt;
      rotCtr++; }
    if (rotCtr != 0) 
#ifdef ACCSX
      rotMultiX = rotCtr << ACCSX;
#else
      rotMultiX = rotCtr;
#endif 
//    else
//      rotMultiX = 0;
      
    rotCtr = 0;
    while (rotPositionX <= -rotCtrLmt) {
      rotPositionX += rotCtrLmt;
      rotCtr++; }
    if (rotCtr != 0) 
#ifdef ACCSX
      rotMultiX = -(rotCtr << ACCSX);
#else
      rotMultiX = -rotCtr;
#endif 
  }
//  Process Y-axis
  rotMultiY = 0;
  if (rotPositionY >= rotCtrLmt || rotPositionY <= -rotCtrLmt) { 
    rotCtr = 0;
    while (rotPositionY >= rotCtrLmt) {
      rotPositionY -= rotCtrLmt;
      rotCtr++; }
    if (rotCtr != 0) 
#ifdef ACCSX
      rotMultiY = rotCtr << ACCSX;
#else
      rotMultiY = rotCtr;
#endif 

    rotCtr = 0;
    while (rotPositionY <= -rotCtrLmt) {
      rotPositionY += rotCtrLmt;
      rotCtr++; }
    if (rotCtr != 0) 
#ifdef ACCSX
      rotMultiY = -(rotCtr << ACCSX);
#else
      rotMultiY = -rotCtr;
#endif 

  }
  if (rotMultiX !=0 || rotMultiY !=0)
    Mouse.move(rotMultiX,rotMultiY,0);
#endif 

//#ifdef ACCM
//  //If the encoder has moved 2 or more transitions move the mouse in the appropriate direction 
//  //and update the position variable to reflect that we moved the mouse. Accelerated move.
//  if(rotPositionX >= 2 || rotPositionX <= -2) {
//    rotMultiX = rotPositionX >> 1;
//    Mouse.move(rotMultiX,0,0);
//    rotPositionX -= (rotMultiX << 1);
//  }
//  if(rotPositionY >= 2 || rotPositionY <= -2) {
//    rotMultiY = rotPositionY >> 1;
//    Mouse.move(0,rotMultiY,0);
//    rotPositionY -= (rotMultiY << 1);
//  }
//#endif 

//#ifdef ACCX
//  //If the encoder has moved 4 or more transitions move the mouse in the appropriate direction 
//  //and update the position variable to reflect that we moved the mouse. Accelerated move.
//  if(rotPositionX >= 4 || rotPositionX <= -4) {
//    rotMultiX = rotPositionX >> 2;
//    Mouse.move(rotMultiX,0,0);
//    rotPositionX -= (rotMultiX << 2);
//  }
//  if(rotPositionY >= 4 || rotPositionY <= -4) {
//    rotMultiY = rotPositionY >> 2;
//    Mouse.move(0,rotMultiY,0);
//    rotPositionY -= (rotMultiY << 2);
//  }
//#endif 

// *** Spinner movement logic ***


//---------------------------------------------------------------------------------------------------
//---------------------------------------------------------------------------------------------------
  //Iterate through the 10 buttons (0-9) assigning the current digital state of pin for each button, 
  //HIGH(0b00000001) or LOW(0b00000000), to currentState variable. 
  //Note: Pro Micro boards use various ports to access different digital pins. 
  //Buttons 1-6, plus 9-select(coin), and 10-start(player) used; buttons 7 & 8 unused
  //Using digital pins 4, 5, 6, 7, 8, 9, 10, and 15 on Pro Micro board. See silk screening.
  //Pins 16 and 14 are free to use.
  //Pins 0, 1, 2 and 3 are used for trackball rotary output as they are interrupt driven.
  int button = 0;
  do {
    switch ( button ) {
      case 0:  //on digital pin 4, PD4 - Arcade Button 1 - X
        currentButtonState = (PIND & xPD4) >> 4;
        break;
      case 1:  //on digital pin 5, PC6 - Arcade Button 2 - A
        currentButtonState = (PINC & xPC6) >> 6;
        break;
      case 2:  //on digital pin 6, PD7 - Arcade Button 3 - B
        currentButtonState = (PIND & xPD7) >> 7;
        break;
      case 3:  //on digital pin 7, PE6 - Arcade Button 4 - Y
        currentButtonState = (PINE & xPE6) >> 6;
        break;
//      case 4:  //on digital pin 8, PB4 - Arcade Button 5 - L
      case 4:  //on digital pin 8, PB4 - Up Sense Button 
        currentButtonState = (PINB & xPB4) >> 4;
        if (currentButtonState == butPrs)
          adjTime = millis() + delayTime;
        break;
//      case 5:  //on digital pin 9, PB5 - Arcade Button 6 - R
      case 5:  //on digital pin 9, PB5 - Down Sense Button 
        currentButtonState = (PINB & xPB5) >> 5;
        if (currentButtonState == butPrs)
          adjTime = millis() + delayTime;
        break;
#ifdef axisEnable
      case 6:  //on digital pin 16, PB2 - Special Axis Button (internal function) - requires PB0 set to master or high
        currentButtonState = (PINB & xPB2) >> 2;
        break; 
#endif  
#ifdef joyStmp
      case 7:  //on digital pin 14, PB3 - 2nd Special Button 
        currentButtonState = (PINB & xPB3) >> 3;
        break; 
#endif
      case 8:  //on digital pin 10, PB6 - COIN/Select Button 9
        currentButtonState = (PINB & xPB6) >> 6;
        break;
      case 9:  //on digital pin 15, PB1 - PLAYER/Start Button 10
        currentButtonState = (PINB & xPB1) >> 1;
        break; 
      default: //Extra digital pins 16, PB2 + PB0(master=hi) and 14, PB3
        currentButtonState = 0b00000000;
        break;
    }
    //If the current state of the pin for each button is different than last time, update the joystick button state
    if(currentButtonState != lastButtonState[button]) {
#ifdef axisEnable
      if (button == axisEnable ) { //change x-axis enable status
        xAxis = !xAxis;
      } 
#endif
      
//    - add if button and state logic to control Mouse.press() or Mouse.release() activity
//    - button press state is low, and not pressed is high
//
//      switch ( button ) {
//        case 4: // LEFT
//          if (currentButtonState == butOff) {
//            Mouse.release(MOUSE_LEFT);
//          } else {
//            Mouse.press(MOUSE_LEFT);
//          }
//          break;
//        case 5: // RIGHT
//          if (currentButtonState == butOff) {
//            Mouse.release(MOUSE_RIGHT);
//          } else {
//            Mouse.press(MOUSE_RIGHT);
//          }
//          break;
//        default: //Extra digital pins
//          break;          
//      }

      if (button == upBut || button == dwnBut) {
        proc_SpinSpeed(currentButtonState, button );    
         
        if (adjTime < millis() && currentButtonState != butPrs) {
          lastButtonState[button] = currentButtonState;
          butLock = 0; }
       }
       else {
         Joystick.setButton(button, !currentButtonState);
    
       //Save the last button state for each button for next time
         lastButtonState[button] = currentButtonState;
       }
    }
    ++button;
  } while (button < maxBut);
}

void proc_SpinSpeed(int currentButtonState, 
                    int button) 
{
  if (currentButtonState == butPrs) {
    if (button == upBut) {
      if (butLock == 0) {
        if (rotCtrLmt > 1)
          rotCtrLmt --;
          lastButtonState[button] = currentButtonState;
        butLock = 1; }
    }
    else {  //dwnBut
      if (butLock == 0) {
        if (rotCtrLmt < 50)
          rotCtrLmt ++;
          lastButtonState[button] = currentButtonState;
        butLock = 1; }
    }
  }
}
  
