CraigB-spinner/Arcade-Trackball/(commit log)

2020-10-12 Create ..ATmega32U4 wired inside.jpg
2020-11-28 Update Trackball_8-Button.ino
    Trackball(mouse) Code for Pro Micro Controller
2020-12-16 Revised code - add x-axis disable for Golf games, driver hook/slice cheat
2020-12-17 Mouse and Joystick (Arcade Spinner) Mod version.
    Mouse and Joystick (Arcade Spinner) Mod version -
    plus directive to disable x-axis using special button (golf drive - no hook/slice cheat),
    and directive to switch to Joystick (button) directions using special button.
2020-12-19 Mouse and Joystick (Arcade Spinner) version.
    Revised code - add x-axis disable for Golf games, driver hook/slice cheat
2021-01-23 Mouse and Joystick (Arcade Spinner) RGB Mod version.
    Mouse and Joystick (Arcade Spinner) RGB Mod version -
    plus directive to activate RGB Led lights under Trackball for colour rotational glow (may require MOSFETs to handle current limits),
    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
2021-01-26 Special Mouse only (Arcade Trackball) version.
    Special Mouse only (Arcade Trackball) version -
    with & without mouse Left/Centre/Right buttons,
    plus 'with' version able to disable x-axis using forth button.
2021-03-11 Mouse and Joystick (Arcade Spinner) RGB Mod version -
    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
2022-12-31 Mouse and Joystick (Arcade Trackball) MiSTer Vari-Speed version.
    Mouse horizontal default (Arcade Trackball) MiSTer-Mod version -
    plus directive to disable x-axis using special button (golf drive - no hook/slice cheat)
2024-08-28 Trackball 2x5 pin connector
